neurobionics/a1201_springHead-master-1--20181022T163141Z-001/a1201_springHead-master (1)/Rouse_Changes/AssemDephy1.SLDASM

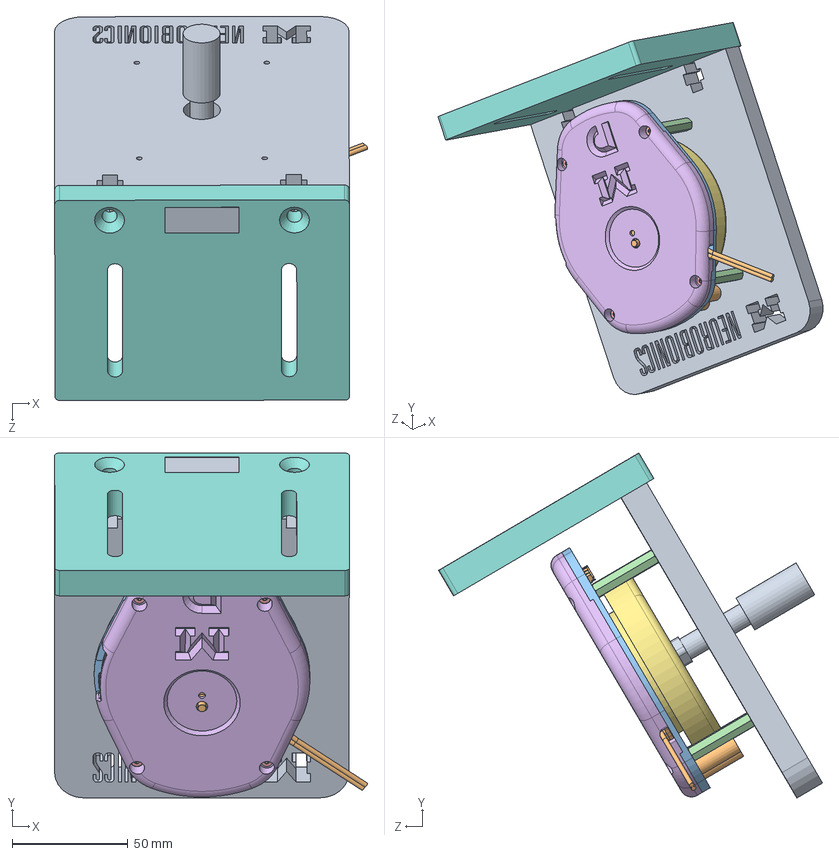
[picture p1: CAD file, 2019-01-08]
a1201_springHead-master (1)/Rouse_Changes/AssemDephy1.SLDASM
134.9 x 148.6 x 165.5 mm
front_MotorMount
DEPHY_FX_RIGID_0_1-simpler
mp-v1
95947A060_ALUM FEM THRDED HEX STANDOFF x 4
92855A309_TYPE 18-8 SS LOW PROFILE SOCKET CAP SCREW x 4
elec-cover-cap
D8-LM-2017-09-12
base_MotorMount
MotorShaft
