neurobionics/a1201_springHead-master-1--20181022T163141Z-001/a1201_springHead-master (1)/Rouse_Changes/a1201_springHead_newpart.SLDASM

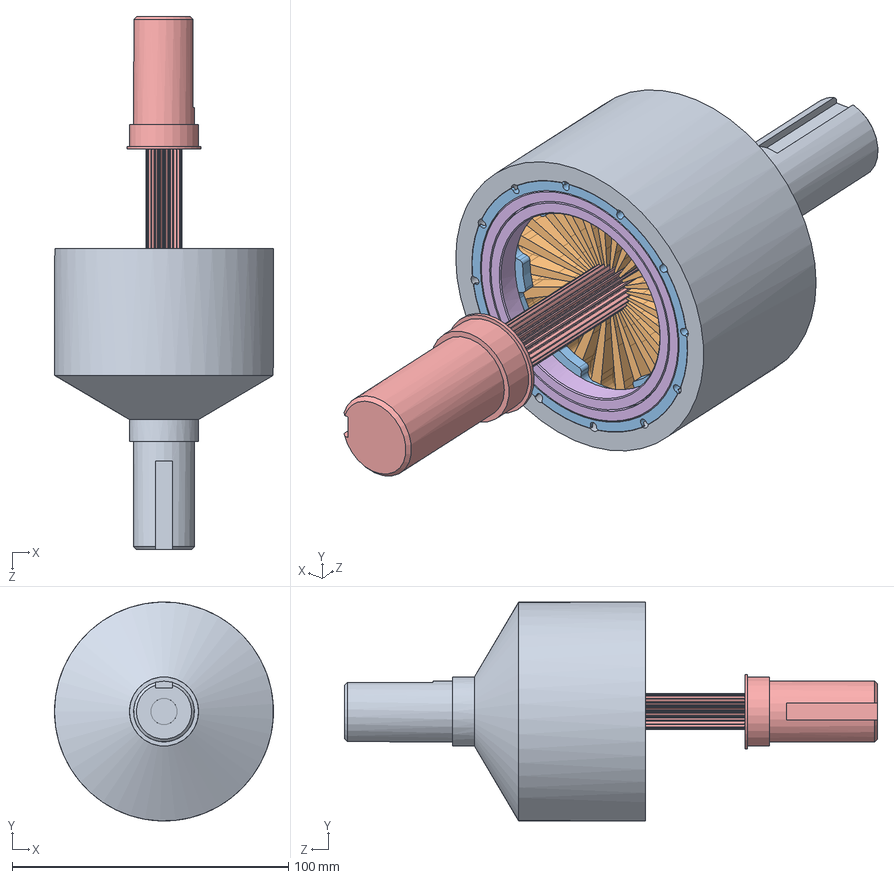
[picture p2: CAD file, 2019-01-08]
a1201_springHead-master (1)/Rouse_Changes/a1201_springHead_newpart.SLDASM
79.3 x 79.2 x 192.9 mm
p1012_stage3OutputPulley_5mm_48teeth_newpart
p1201_springV2 x 6
p1203_springStop
p1204_gearStopSpring
p1205_springGear_sdpsi_A_1C29MY05024_newpart
z_ultraThinBallBearing_mcmaster_6656K110
91595A142_METRIC ALLOY STEEL DOWEL PIN x 12
