neurobionics/a1201_springHead-master-1--20181022T163141Z-001/a1201_springHead-master (1)/PL2090-Double-P0403200503.SLDASM

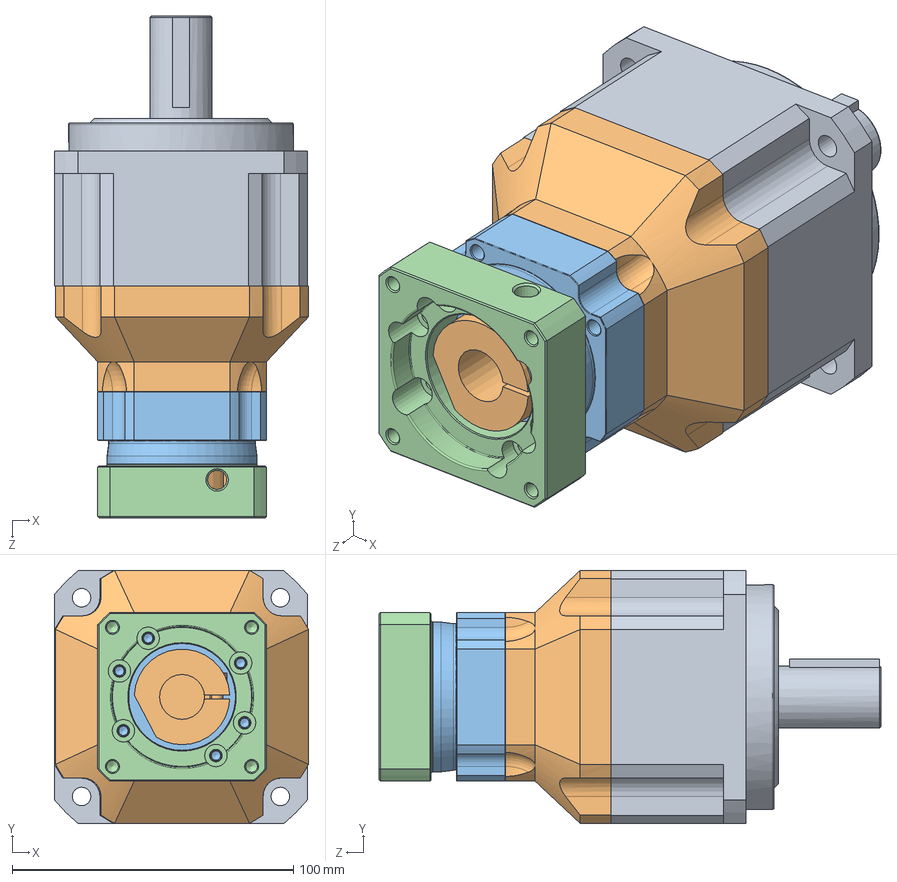
[picture p3: CAD file, 2018-11-18]
a1201_springHead-master (1)/PL2090-Double-P0403200503.SLDASM
90.4 x 90.1 x 178.5 mm
AB0902
AB0902-1
PK920001
P4120403
