neurobionics/a1201_springHead-master-1--20181022T163141Z-001/a1201_springHead-master (1)/Test Fixture parts/test fixture.SLDASM

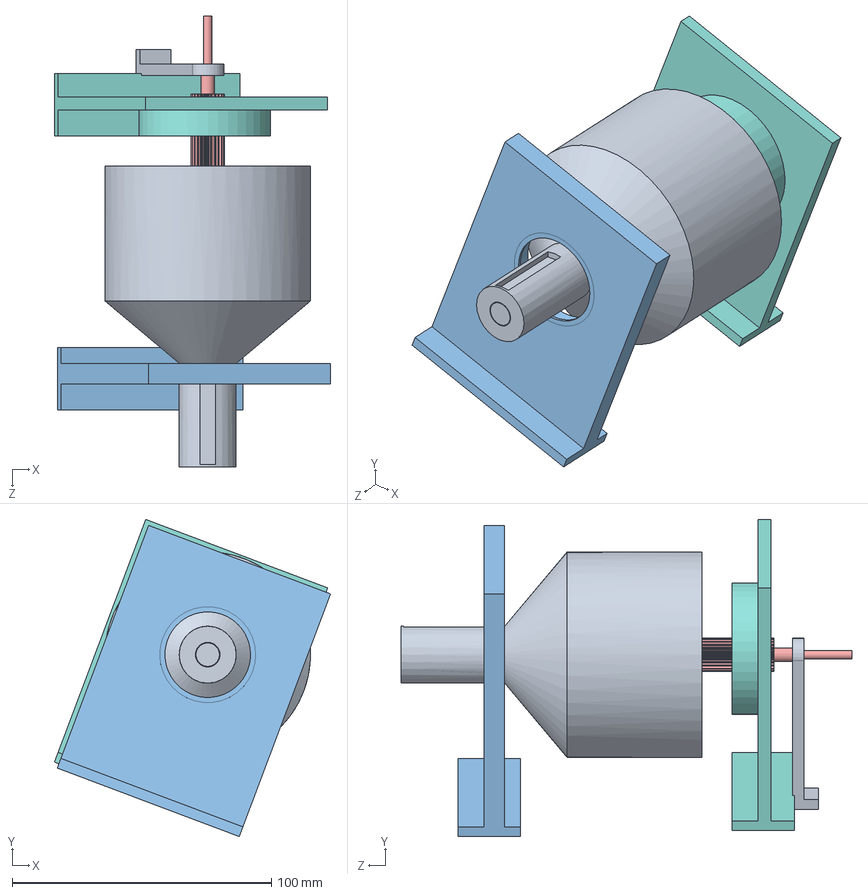
[picture p4: CAD file, 2018-10-22]
a1201_springHead-master (1)/Test Fixture parts/test fixture.SLDASM
106.5 x 122.3 x 173.9 mm
p1012_stage3OutputPulley_5mm_48teeth_newpart
p1201_springV2 x 6
p1203_springStop x 2
p1204_gearStopSpring x 2
p1205_springGear_sdpsi_A_1C29MY05024_newpart
z_ultraThinBallBearing_mcmaster_6656K110 x 2
z_dowelPin_3mm_5mm_mcmaster_91595A143 x 12
HoldingFixture
bearing fixture
57155K349_STAINLESS STEEL BALL BEARING x 2
HoldingFixtureRight
