neurobionics/a1201_springHead-master-1--20181022T163141Z-001/a1201_springHead-master (1)/Rouse_Changes/Motor-package.SLDASM

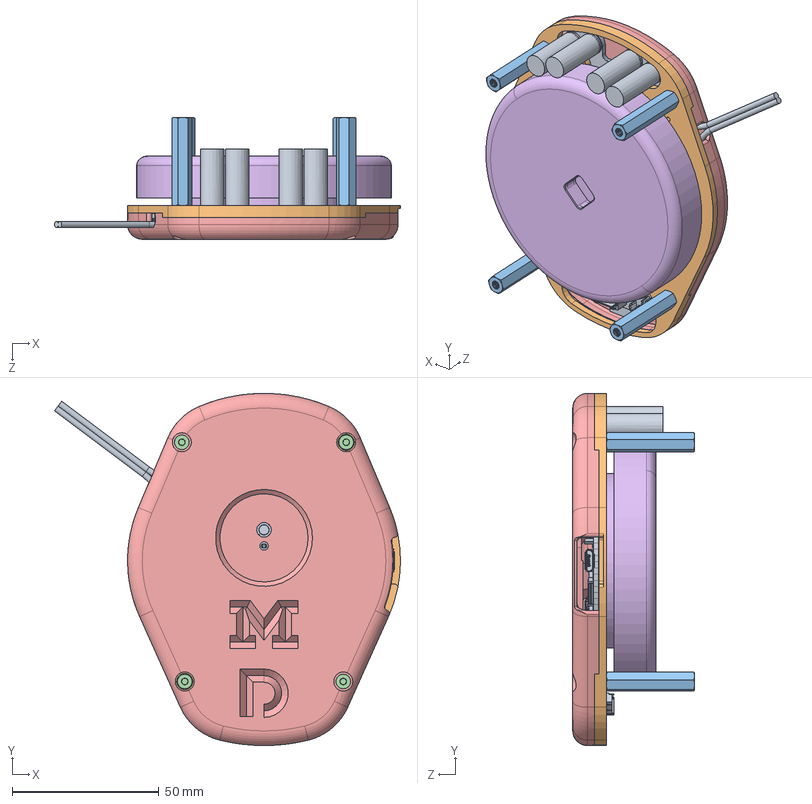
[picture p5: CAD file, 2018-12-12]
a1201_springHead-master (1)/Rouse_Changes/Motor-package.SLDASM
117.9 x 120.0 x 41.6 mm
DEPHY_FX_RIGID_0_1-simpler
mp-v1
95947A060_ALUM FEM THRDED HEX STANDOFF x 4
92855A309_TYPE 18-8 SS LOW PROFILE SOCKET CAP SCREW x 4
elec-cover-cap
D8-LM-2017-09-12
