neurobionics/a1201_springHead-master-1--20181022T163141Z-001/a1201_springHead-master (1)/a1201_springHead.SLDASM

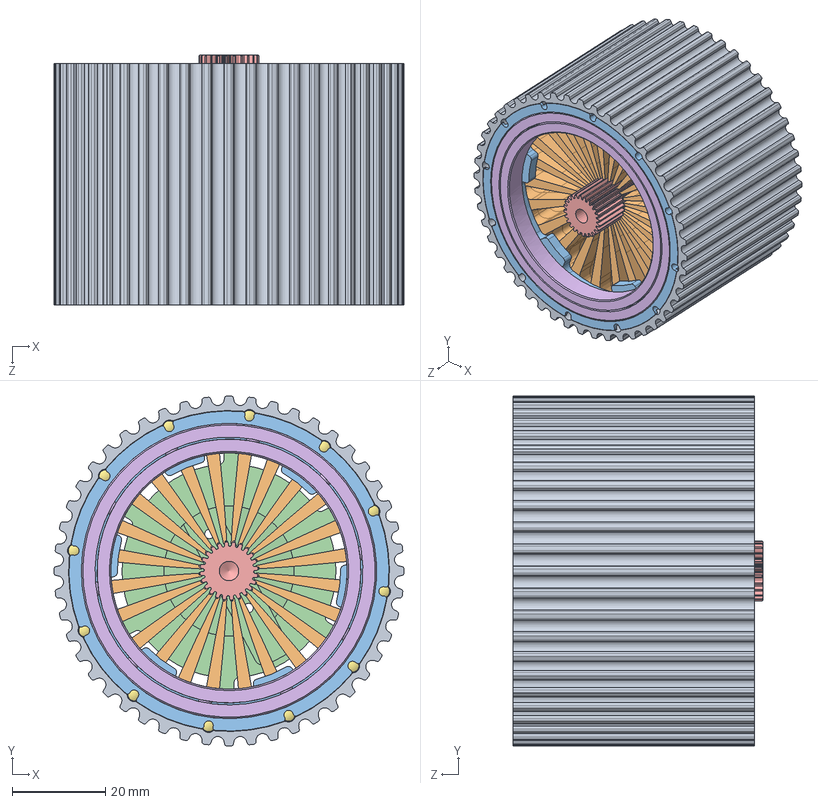
[picture p7: CAD file, 2018-10-22]
a1201_springHead-master (1)/a1201_springHead.SLDASM
75.3 x 75.3 x 53.8 mm
p1012_stage3OutputPulley_5mm_48teeth_sdpsi_A_6A54M048GT20
p1201_springV2 x 6
p1203_springStop x 2
p1204_gearStopSpring x 2
p1205_springGear_sdpsi_A_1C29MY05024
z_ultraThinBallBearing_mcmaster_6656K110 x 2
z_dowelPin_3mm_5mm_mcmaster_91595A143 x 12
