neurobionics/a1201_springHead-master-1--20181022T163141Z-001/a1201_springHead-master (1)/p1012_stage3OutputPulley_5mm_48teeth_newpart.STEP

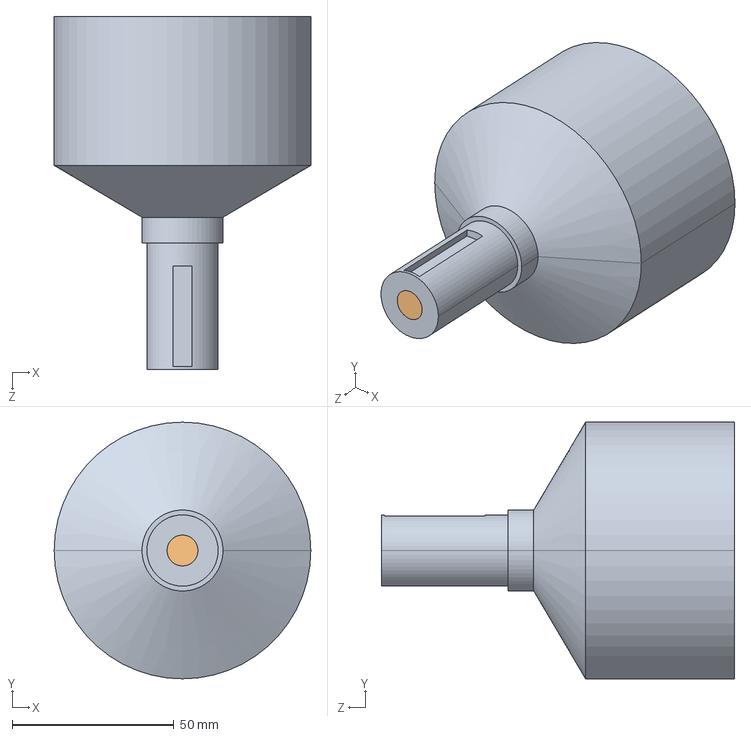
[picture p9: CAD file, 2019-01-06]
a1201_springHead-master (1)/p1012_stage3OutputPulley_5mm_48teeth_newpart.STEP
79.3 x 79.3 x 109.0 mm
