neurobionics/a1201_springHead-master-1--20181022T163141Z-001/a1201_springHead-master (1)/parts for quotes/holding fixture base 2.STEP

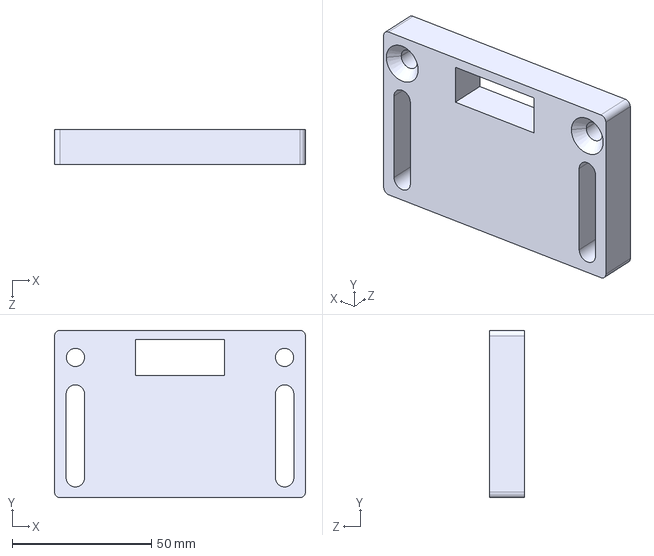
[picture p10: CAD file, 2019-01-06]
a1201_springHead-master (1)/parts for quotes/holding fixture base 2.STEP
90.0 x 60.0 x 12.7 mm
