neurobionics/a1201_springHead-master-1--20181022T163141Z-001/a1201_springHead-master (1)/Rouse_Changes/MB6090_M-Solidworks.SLDPRT

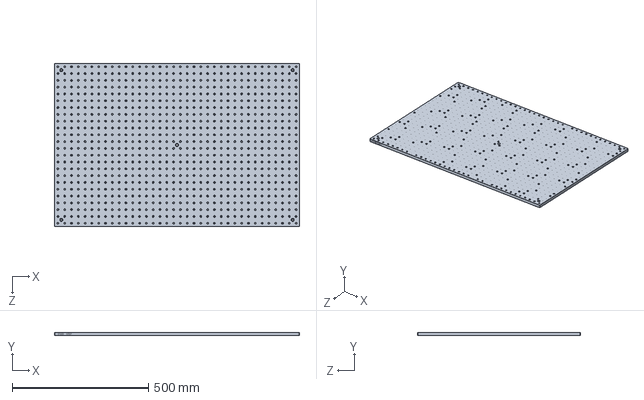
[picture p11: CAD file, 2019-01-11]
a1201_springHead-master (1)/Rouse_Changes/MB6090_M-Solidworks.SLDPRT
900.0 x 12.7 x 600.0 mm
