neurobionics/a1201_springHead-master-1--20181022T163141Z-001/a1201_springHead-master (1)/Key.STEP

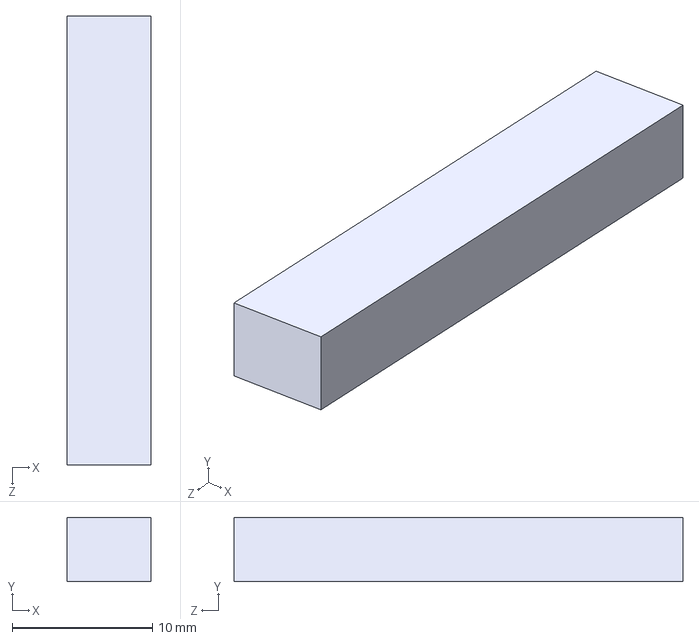
[picture p12: CAD file, 2019-01-06]
a1201_springHead-master (1)/Key.STEP
6.00 x 4.58 x 32.0 mm
