neurobionics/a1201_springHead-master-1--20181022T163141Z-001/a1201_springHead-master (1)/parts for quotes/base_MotorMount.STEP

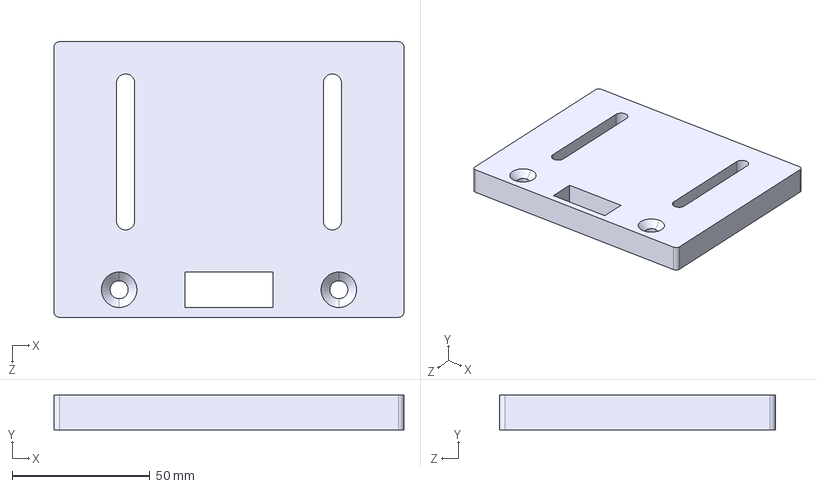
[picture p13: CAD file, 2019-01-06]
a1201_springHead-master (1)/parts for quotes/base_MotorMount.STEP
127.0 x 12.7 x 100.0 mm
