neurobionics/a1201_springHead-master-1--20181022T163141Z-001/a1201_springHead-master (1)/Test Fixture parts/HoldingFixtureRight.SLDPRT

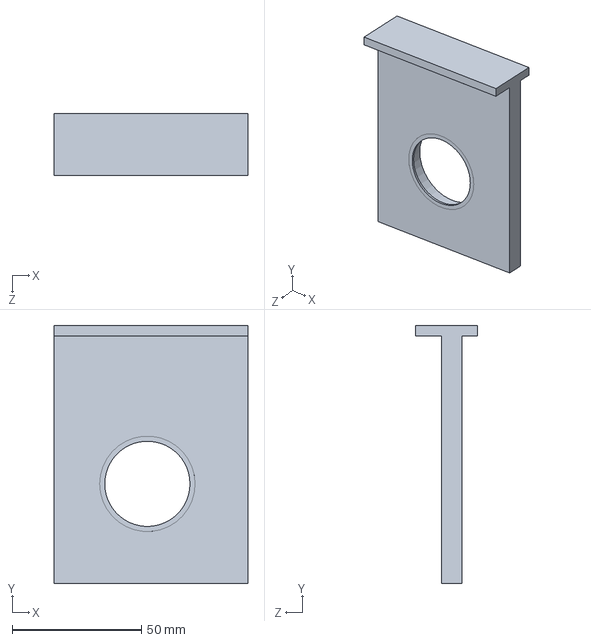
[picture p15: CAD file, 2018-10-22]
a1201_springHead-master (1)/Test Fixture parts/HoldingFixtureRight.SLDPRT
75.0 x 100.0 x 24.0 mm
