neurobionics/a1201_springHead-master-1--20181022T163141Z-001/a1201_springHead-master (1)/p1205_springGear_sdpsi_A_1C29MY05024_newpart.STEP

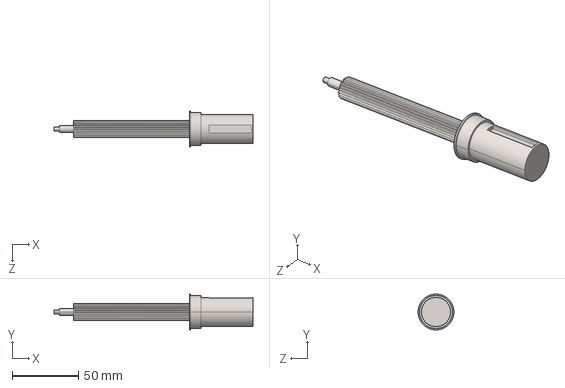
[picture p16: CAD file, 2019-01-06]
a1201_springHead-master (1)/p1205_springGear_sdpsi_A_1C29MY05024_newpart.STEP
149.9 x 27.0 x 27.0 mm
