neurobionics/a1201_springHead-master-1--20181022T163141Z-001/a1201_springHead-master (1)/parts for quotes/transmission coupler.STEP

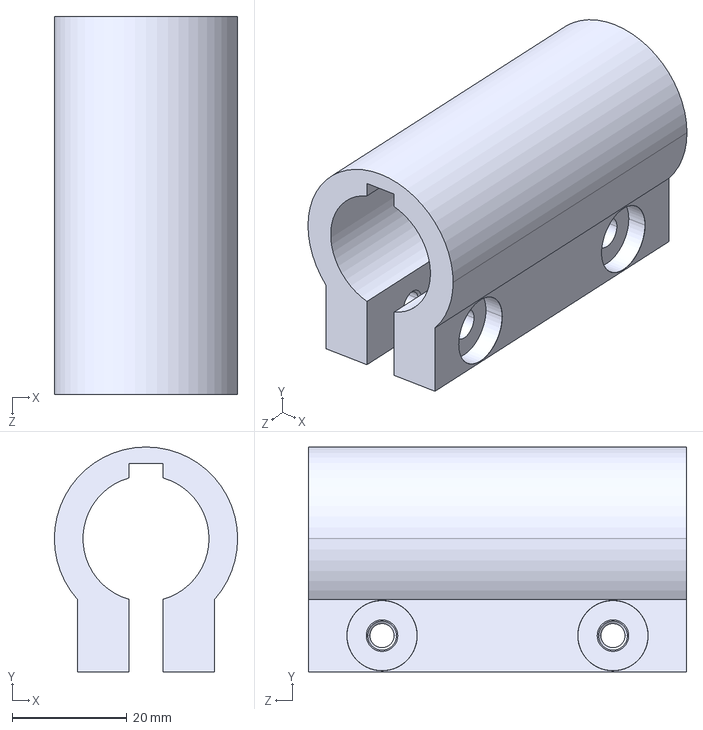
[picture p17: CAD file, 2019-01-06]
a1201_springHead-master (1)/parts for quotes/transmission coupler.STEP
32.0 x 39.3 x 66.0 mm
