neurobionics/a1201_springHead-master-1--20181022T163141Z-001/a1201_springHead-master (1)/Test Fixture parts/p1204_gearStopSpring.SLDPRT

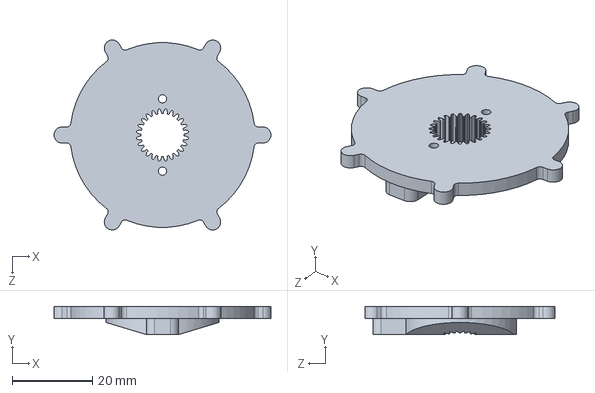
[picture p18: CAD file, 2018-10-22]
a1201_springHead-master (1)/Test Fixture parts/p1204_gearStopSpring.SLDPRT
54.0 x 7.00 x 47.3 mm
