neurobionics/a1201_springHead-master-1--20181022T163141Z-001/a1201_springHead-master (1)/HoldingFixtureRight.STEP

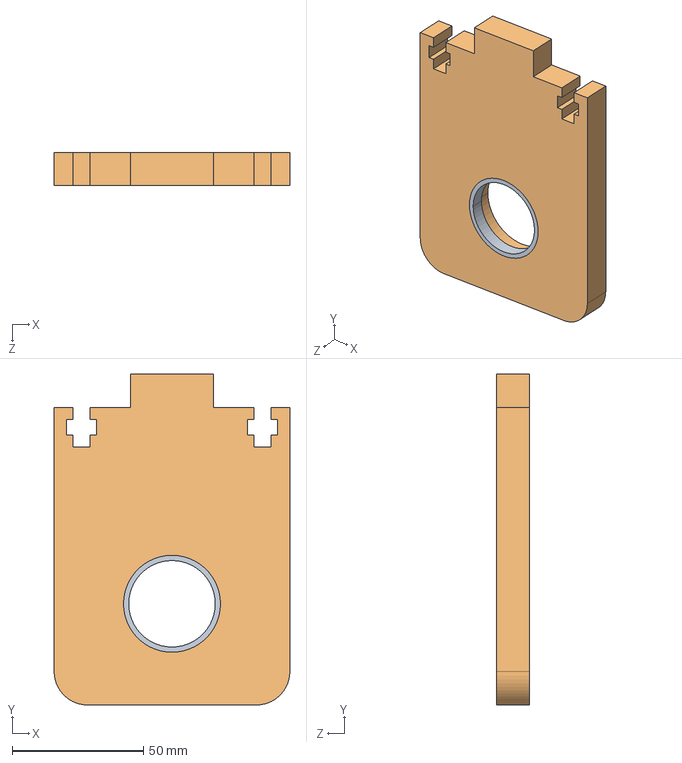
[picture p19: CAD file, 2019-01-06]
a1201_springHead-master (1)/HoldingFixtureRight.STEP
90.0 x 126.3 x 12.7 mm
