neurobionics/a1201_springHead-master-1--20181022T163141Z-001/a1201_springHead-master (1)/parts for quotes/HoldingFixture.STEP

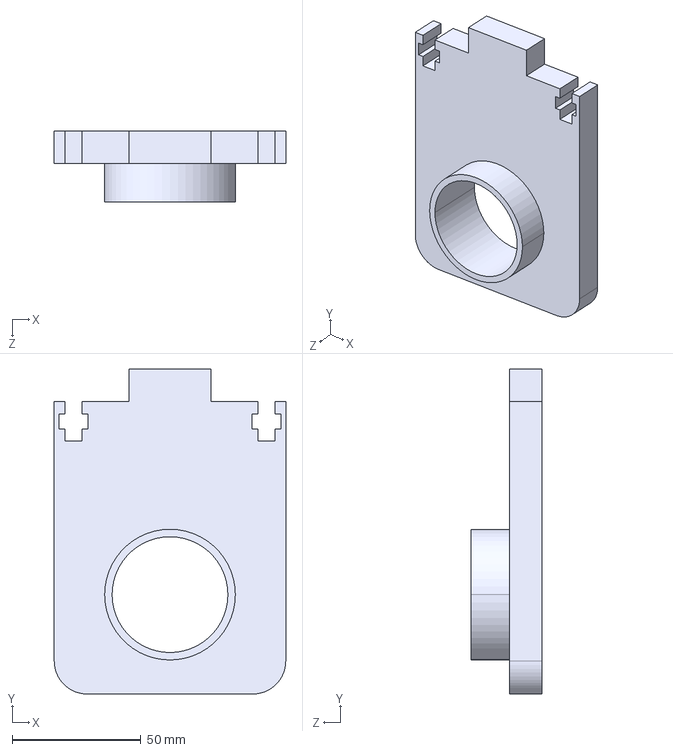
[picture p20: CAD file, 2019-01-06]
a1201_springHead-master (1)/parts for quotes/HoldingFixture.STEP
90.0 x 126.3 x 27.7 mm
