neurobionics/a1201_springHead-master-1--20181022T163141Z-001/a1201_springHead-master (1)/Test Fixture parts/p1205_springGear_sdpsi_A_1C29MY05024_newpart.SLDPRT

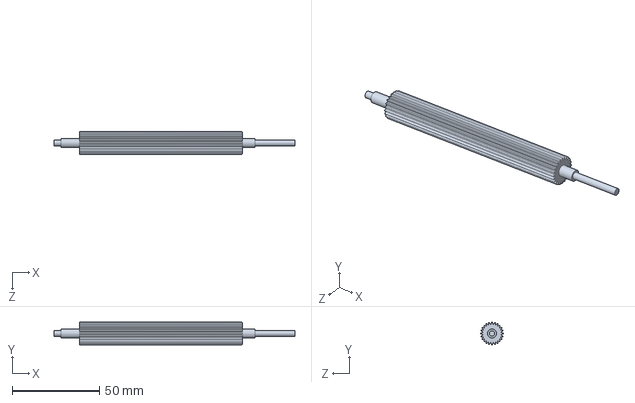
[picture p21: CAD file, 2018-10-22]
a1201_springHead-master (1)/Test Fixture parts/p1205_springGear_sdpsi_A_1C29MY05024_newpart.SLDPRT
137.9 x 13.0 x 13.0 mm
