neurobionics/a1201_springHead-master-1--20181022T163141Z-001/a1201_springHead-master (1)/parts for quotes/holding fixture base1.STEP

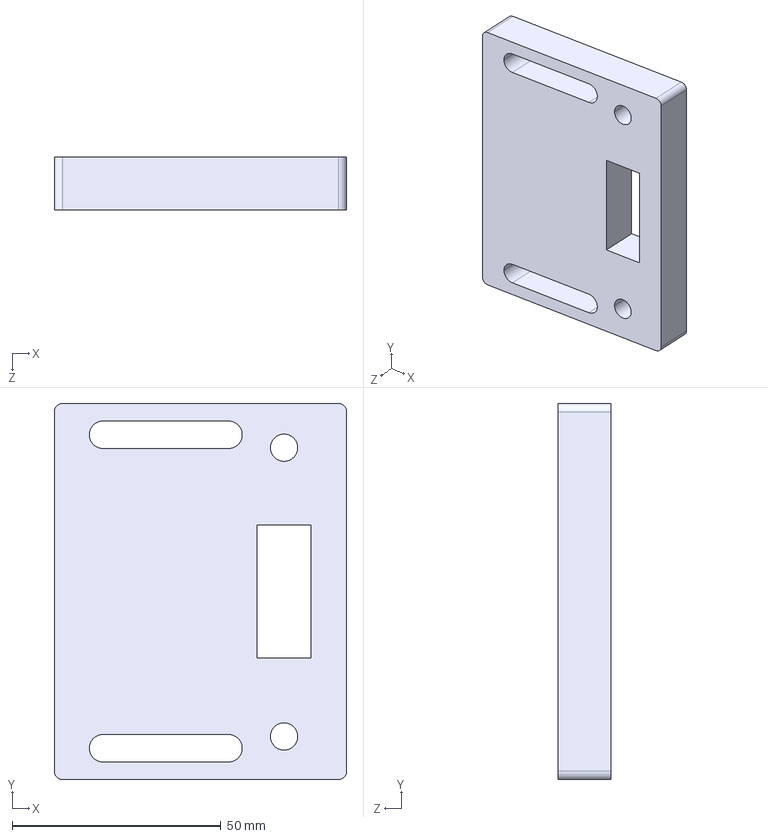
[picture p22: CAD file, 2019-01-06]
a1201_springHead-master (1)/parts for quotes/holding fixture base1.STEP
70.0 x 90.0 x 12.7 mm
