neurobionics/a1201_springHead-master-1--20181022T163141Z-001/a1201_springHead-master (1)/Rouse_Changes/p1203_springStop.STEP

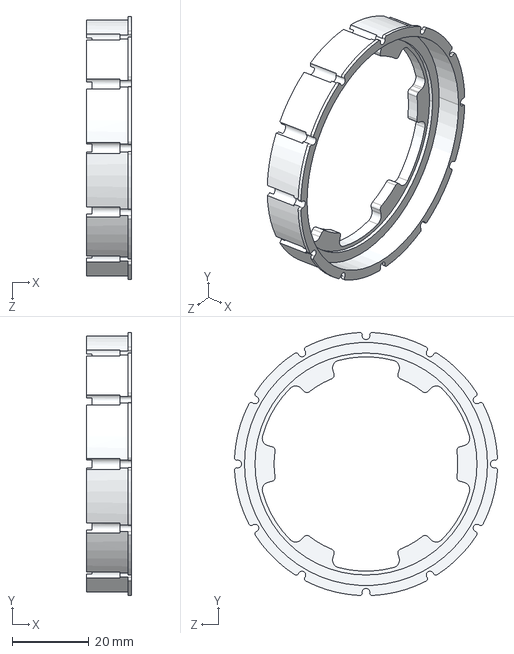
[picture p23: CAD file, 2019-01-08]
a1201_springHead-master (1)/Rouse_Changes/p1203_springStop.STEP
11.7 x 68.7 x 68.7 mm
