neurobionics/a1201_springHead-master-1--20181022T163141Z-001/a1201_springHead-master (1)/Test Fixture parts/p1201_springV2.SLDPRT

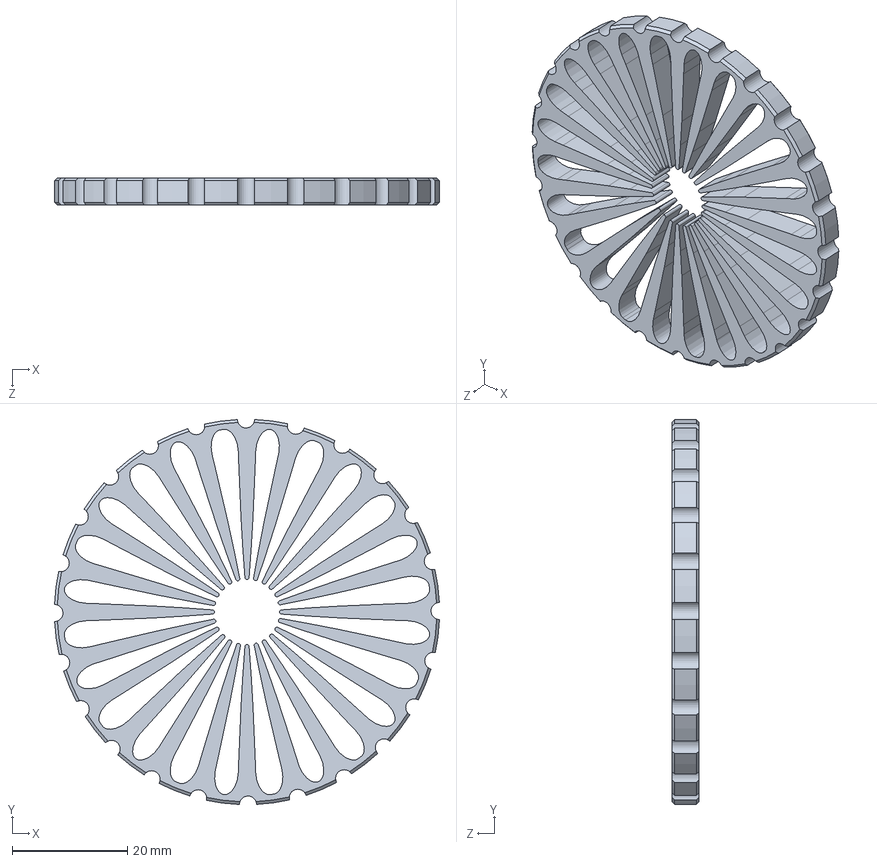
[picture p24: CAD file, 2018-10-22]
a1201_springHead-master (1)/Test Fixture parts/p1201_springV2.SLDPRT
66.9 x 66.9 x 4.76 mm
