neurobionics/a1201_springHead-master-1--20181022T163141Z-001/a1201_springHead-master (1)/AB0902.sldprt

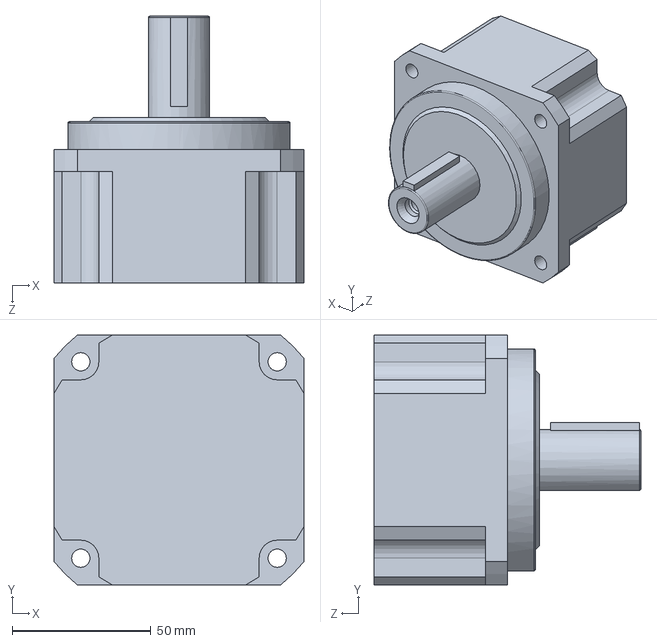
[picture p25: CAD file, 2018-11-18]
a1201_springHead-master (1)/AB0902.sldprt
90.0 x 90.0 x 96.0 mm
