neurobionics/a1201_springHead-master-1--20181022T163141Z-001/a1201_springHead-master (1)/parts for quotes/transmission mount 2.STEP

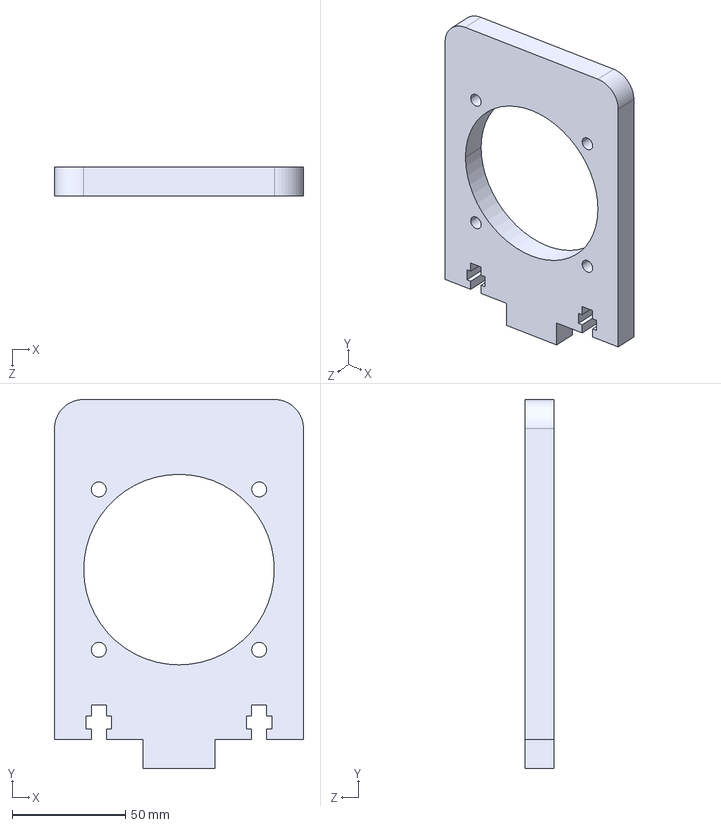
[picture p26: CAD file, 2019-01-06]
a1201_springHead-master (1)/parts for quotes/transmission mount 2.STEP
109.8 x 162.7 x 12.7 mm
