neurobionics/a1201_springHead-master-1--20181022T163141Z-001/a1201_springHead-master (1)/Rouse_Changes/front_MotorMount.STEP

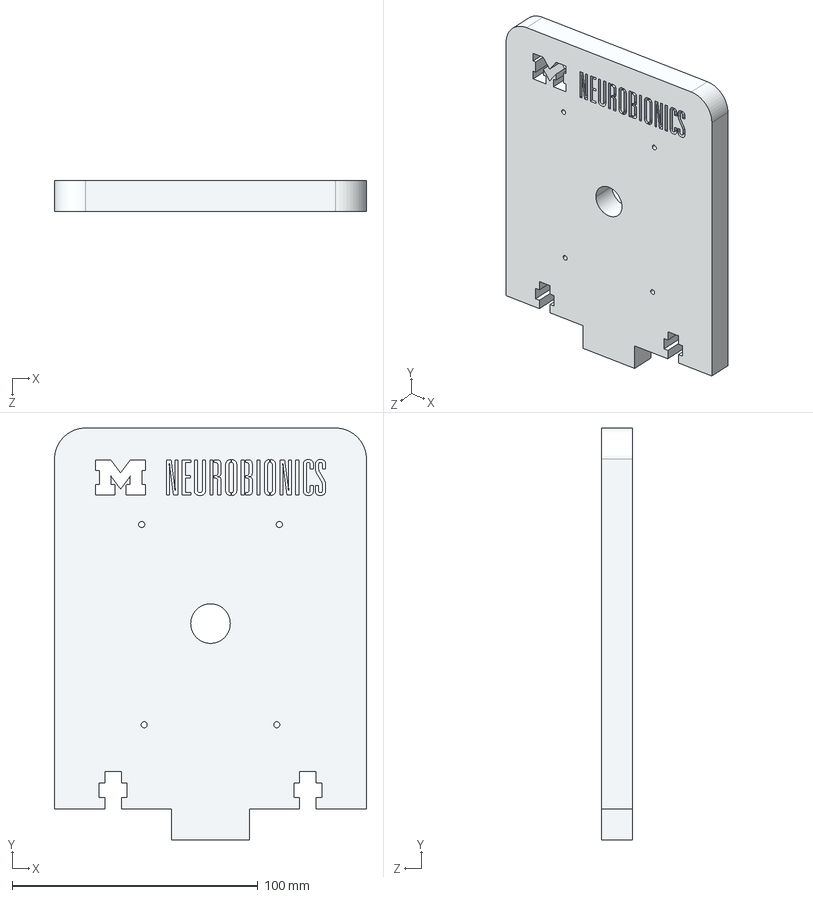
[picture p27: CAD file, 2019-01-06]
a1201_springHead-master (1)/Rouse_Changes/front_MotorMount.STEP
127.0 x 167.7 x 12.7 mm
