neurobionics/a1201_springHead-master-1--20181022T163141Z-001/a1201_springHead-master (1)/Rouse_Changes/transmission mount base.STEP

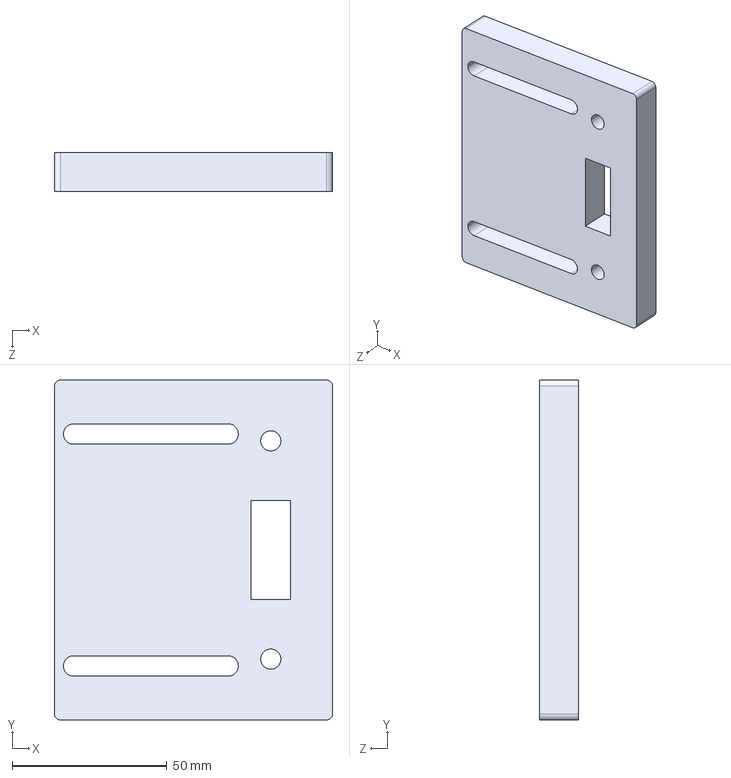
[picture p29: CAD file, 2019-01-06]
a1201_springHead-master (1)/Rouse_Changes/transmission mount base.STEP
90.0 x 110.0 x 12.7 mm
