neurobionics/a1201_springHead-master-1--20181022T163141Z-001/a1201_springHead-master (1)/Test Fixture parts/bearing fixture.SLDPRT

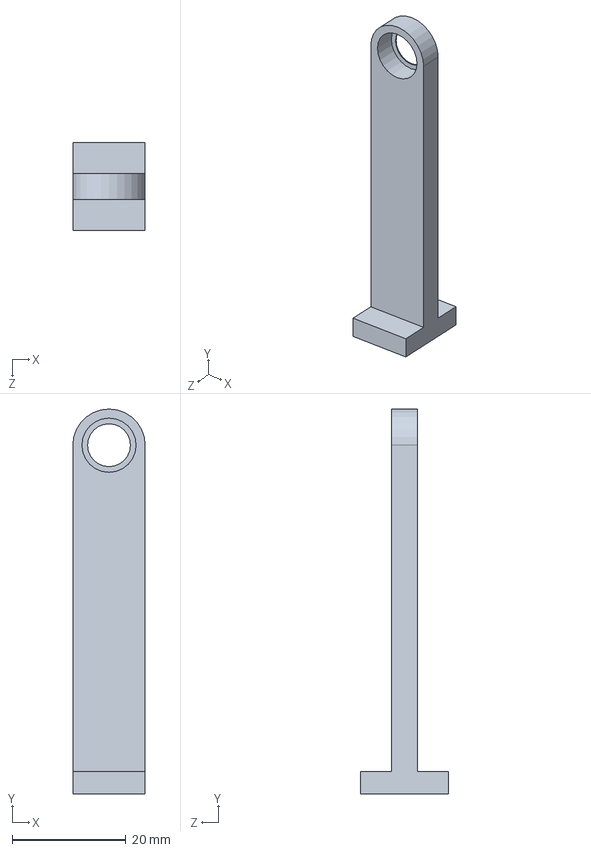
[picture p30: CAD file, 2018-10-22]
a1201_springHead-master (1)/Test Fixture parts/bearing fixture.SLDPRT
12.7 x 67.7 x 15.5 mm
