neurobionics/a1201_springHead-master-1--20181022T163141Z-001/a1201_springHead-master (1)/transmission mount 2.SLDPRT

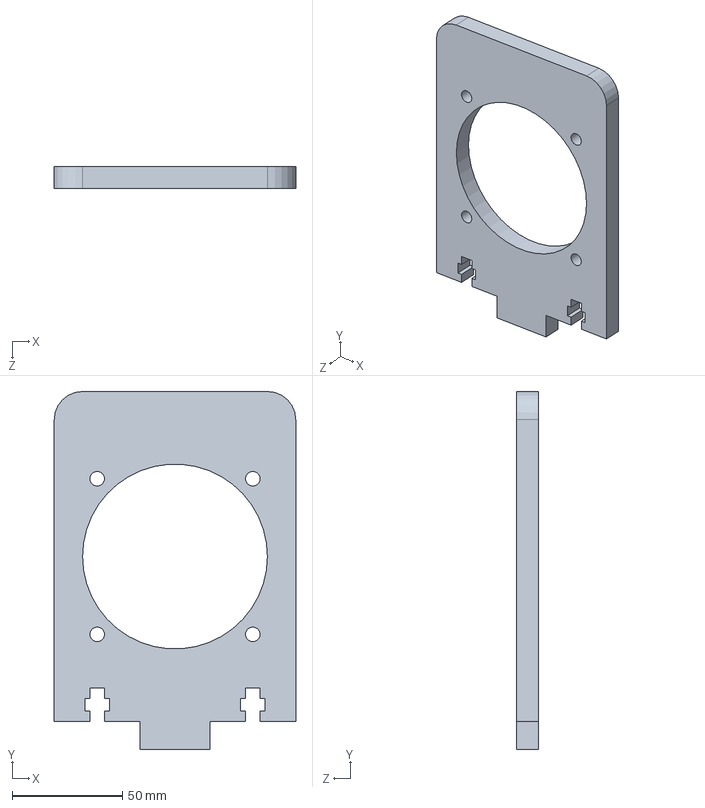
[picture p31: CAD file, 2018-11-18]
a1201_springHead-master (1)/transmission mount 2.SLDPRT
109.8 x 162.7 x 10.0 mm
