neurobionics/a1201_springHead-master-1--20181022T163141Z-001/a1201_springHead-master (1)/Rouse_Changes/HoldingFixtureRight.SLDPRT

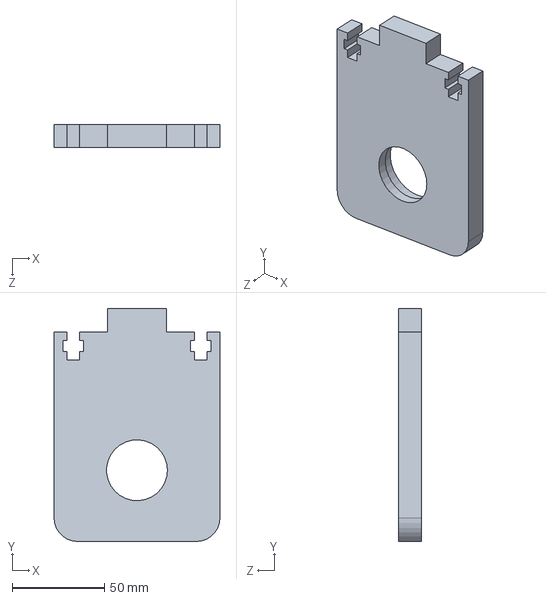
[picture p33: CAD file, 2018-12-21]
a1201_springHead-master (1)/Rouse_Changes/HoldingFixtureRight.SLDPRT
90.0 x 126.3 x 12.7 mm
