neurobionics/a1201_springHead-master-1--20181022T163141Z-001/a1201_springHead-master (1)/Rouse_Changes/transmission coupler.SLDPRT

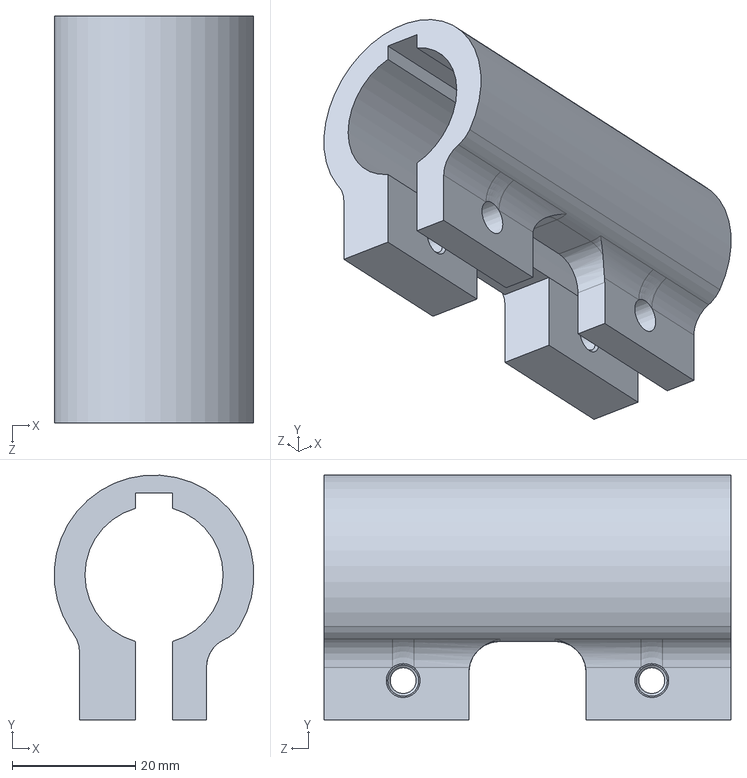
[picture p34: CAD file, 2018-12-21]
a1201_springHead-master (1)/Rouse_Changes/transmission coupler.SLDPRT
32.3 x 39.7 x 66.0 mm
