neurobionics/a1201_springHead-master-1--20181022T163141Z-001/a1201_springHead-master (1)/holdingfixture base.SLDPRT

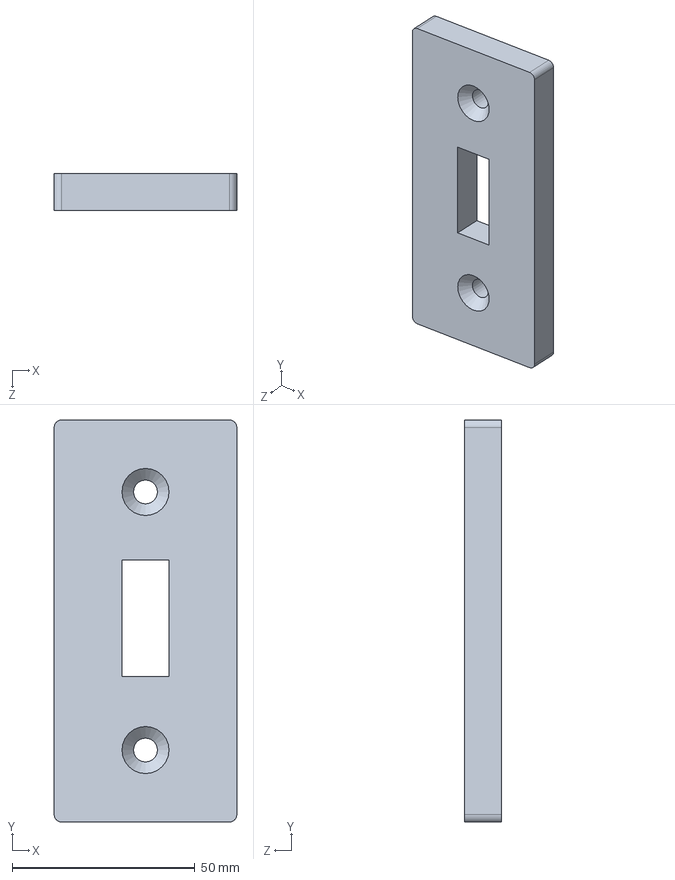
[picture p35: CAD file, 2018-10-26]
a1201_springHead-master (1)/holdingfixture base.SLDPRT
50.0 x 110.0 x 10.0 mm
