neurobionics/a1201_springHead-master-1--20181022T163141Z-001/a1201_springHead-master (1)/transmission mount.SLDPRT

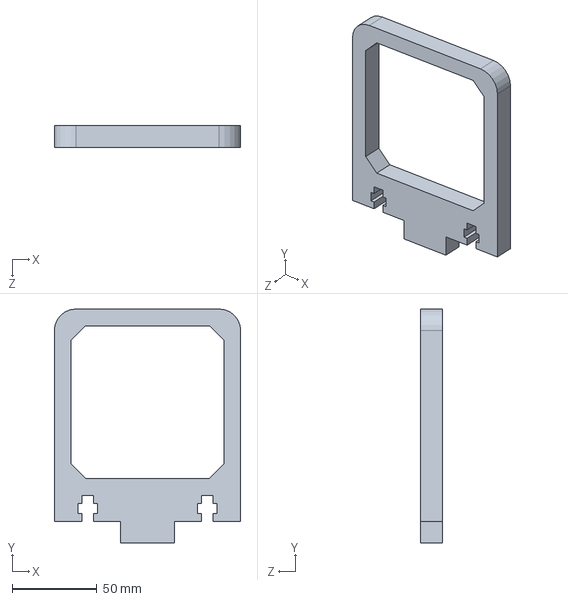
[picture p36: CAD file, 2018-10-25]
a1201_springHead-master (1)/transmission mount.SLDPRT
110.0 x 138.1 x 12.7 mm
