neurobionics/a1201_springHead-master-1--20181022T163141Z-001/a1201_springHead-master (1)/Rouse_Changes/elec-cover-cap.SLDPRT

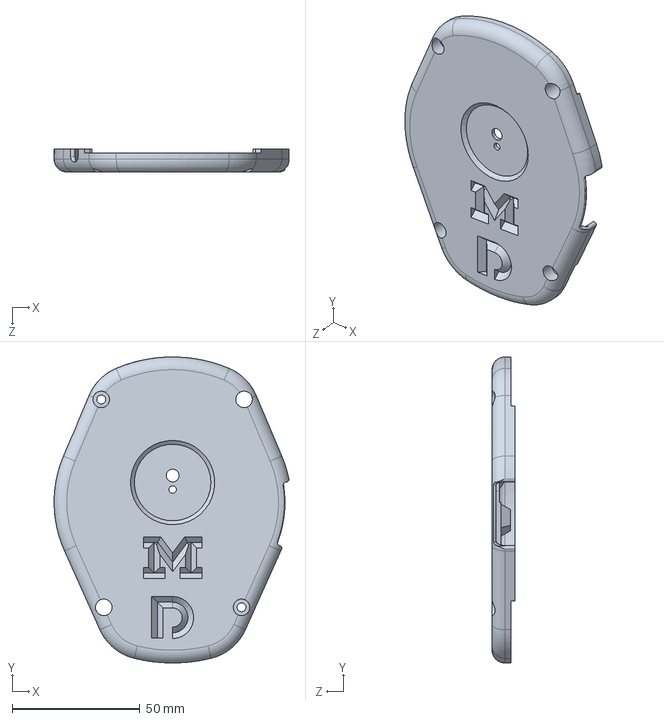
[picture p38: CAD file, 2018-12-12]
a1201_springHead-master (1)/Rouse_Changes/elec-cover-cap.SLDPRT
92.1 x 120.0 x 9.00 mm
