neurobionics/a1201_springHead-master-1--20181022T163141Z-001/a1201_springHead-master (1)/p1012_stage3OutputPulley_5mm_48teeth_sdpsi_A_6A54M048GT20.SLDPRT

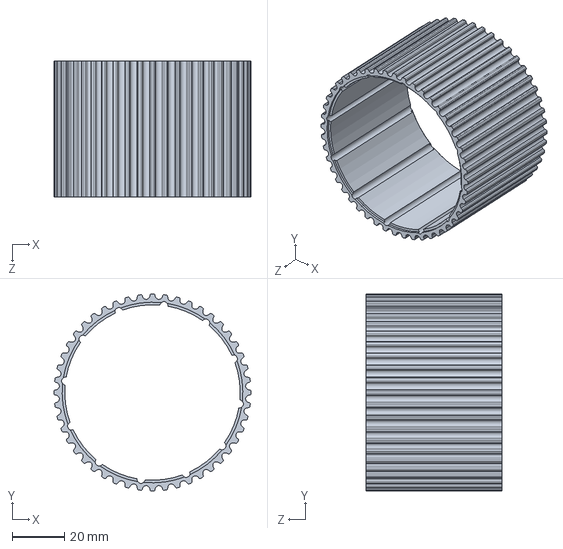
[picture p39: CAD file, 2018-10-22]
a1201_springHead-master (1)/p1012_stage3OutputPulley_5mm_48teeth_sdpsi_A_6A54M048GT20.SLDPRT
75.3 x 75.3 x 52.0 mm
