neurobionics/a1201_springHead-master-1--20181022T163141Z-001/a1201_springHead-master (1)/Rouse_Changes/mp-v1.SLDPRT

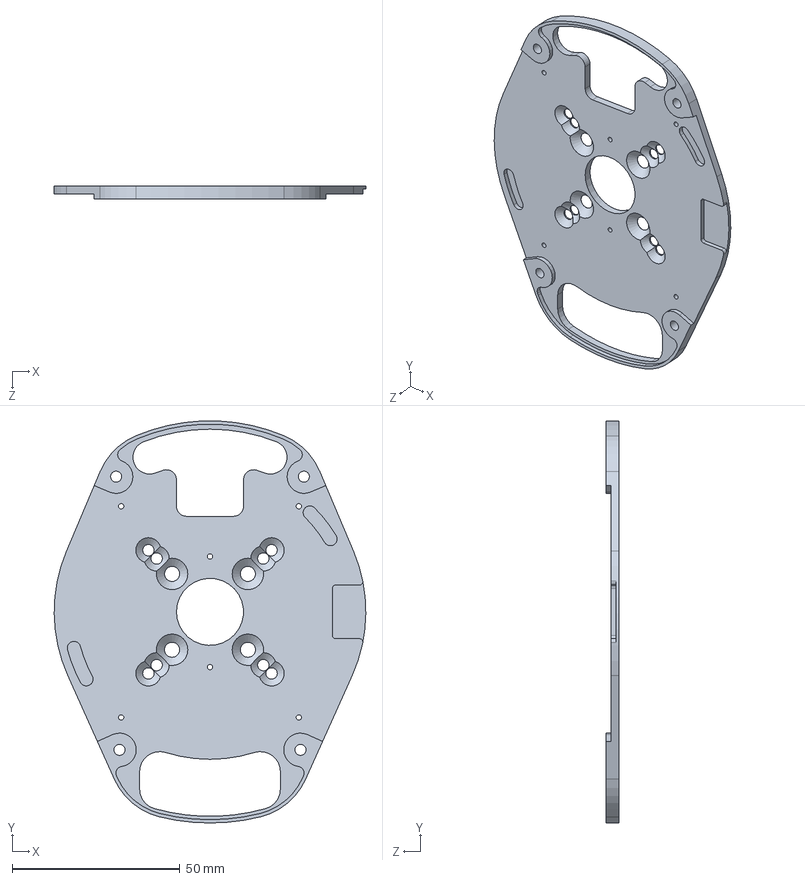
[picture p40: CAD file, 2018-12-12]
a1201_springHead-master (1)/Rouse_Changes/mp-v1.SLDPRT
93.0 x 119.9 x 4.00 mm
