neurobionics/a1201_springHead-master-1--20181022T163141Z-001/a1201_springHead-master (1)/inner gear shaft.SLDPRT

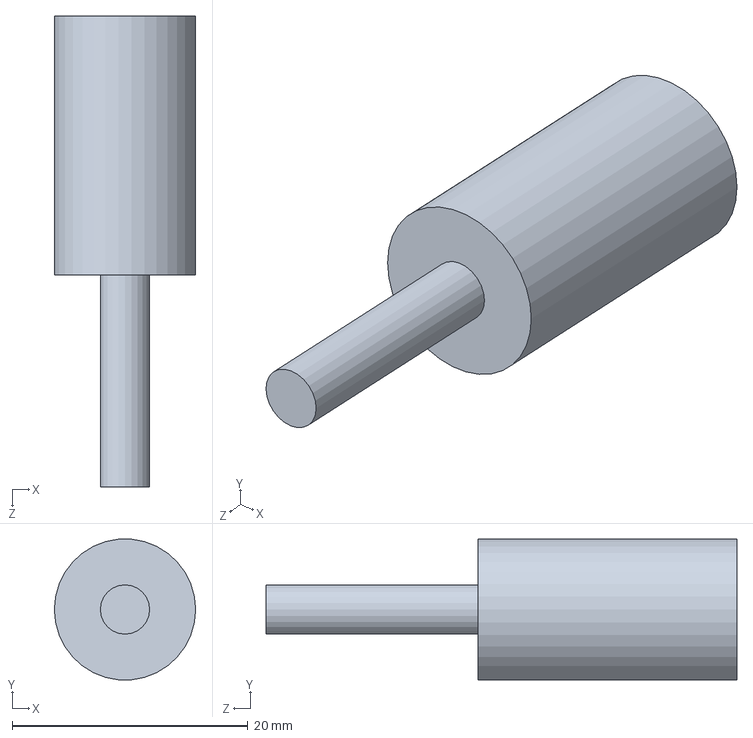
[picture p41: CAD file, 2018-10-22]
a1201_springHead-master (1)/inner gear shaft.SLDPRT
12.0 x 11.9 x 40.0 mm
