neurobionics/a1201_springHead-master-1--20181022T163141Z-001/a1201_springHead-master (1)/Rouse_Changes/D8-LM-2017-09-12.SLDPRT

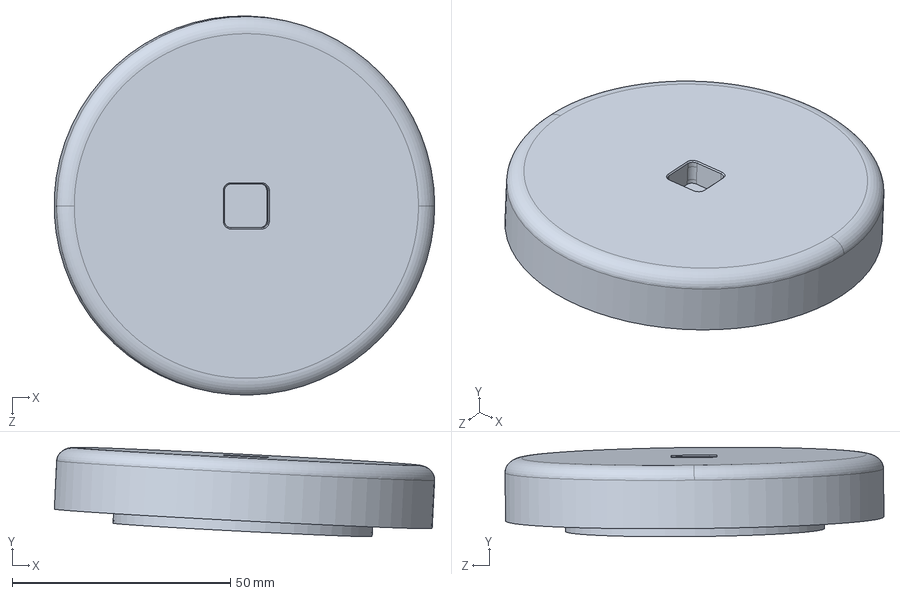
[picture p42: CAD file, 2018-12-12]
a1201_springHead-master (1)/Rouse_Changes/D8-LM-2017-09-12.SLDPRT
87.2 x 20.5 x 86.9 mm
