neurobionics/a1201_springHead-master-1--20181022T163141Z-001/a1201_springHead-master (1)/PGD110-50A2.STEP

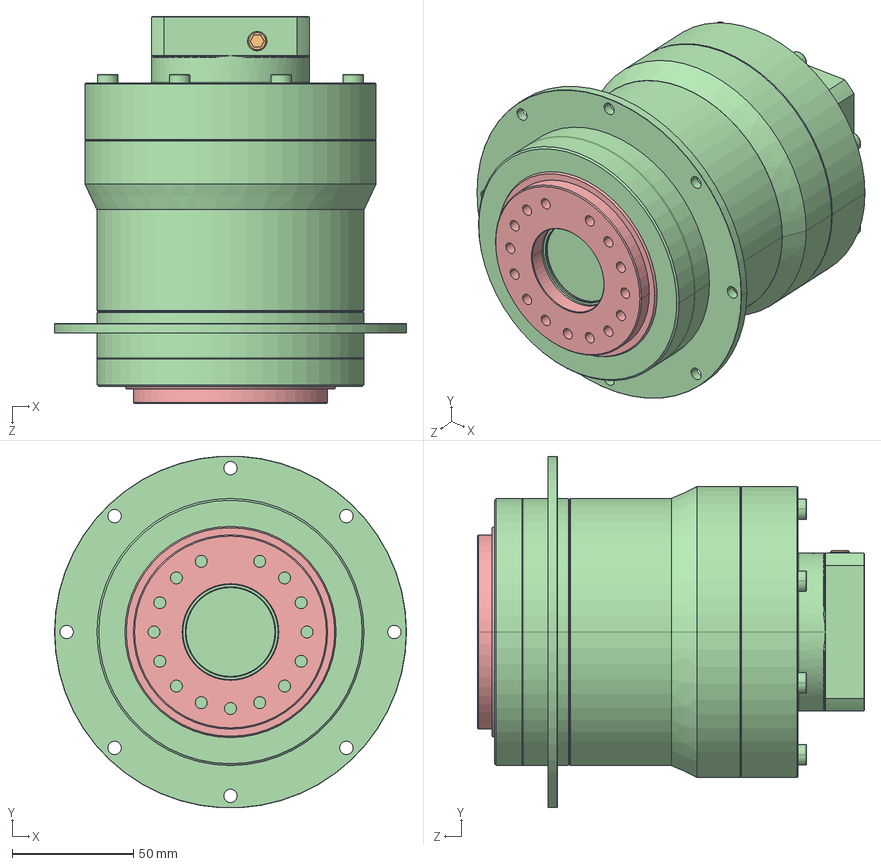
[picture p43: CAD file, 2018-10-22]
a1201_springHead-master (1)/PGD110-50A2.STEP
145.0 x 144.8 x 159.5 mm
