neurobionics/a1201_springHead-master-1--20181022T163141Z-001/a1201_springHead-master (1)/motor coupling.SLDPRT

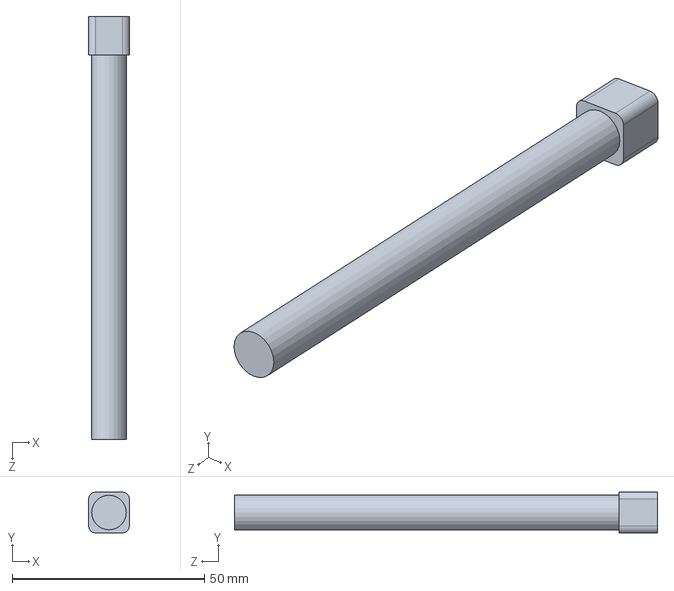
[picture p44: CAD file, 2018-10-22]
a1201_springHead-master (1)/motor coupling.SLDPRT
10.6 x 10.6 x 110.0 mm
