neurobionics/a1201_springHead-master-1--20181022T163141Z-001/(list of files, cad)

Other CAD files:
a1201_springHead-master (1)/a1201_springHead_newpart.SLDASM
a1201_springHead-master (1)/AssemDephy1.SLDASM
a1201_springHead-master (1)/Rouse_Changes/PL2090-Double-P0403200503.SLDASM
a1201_springHead-master (1)/Rouse_Changes/p1204_gearStopSpring.STEP
a1201_springHead-master (1)/Test Fixture parts/p1203_springStop.SLDPRT
a1201_springHead-master (1)/holding fixture base1.SLDPRT
a1201_springHead-master (1)/base_MotorMount.SLDPRT
a1201_springHead-master (1)/front_MotorMount.SLDPRT
a1201_springHead-master (1)/holding fixture base 3.SLDPRT
a1201_springHead-master (1)/Rouse_Changes/HoldingFixture.SLDPRT
a1201_springHead-master (1)/holding fixture base 2.SLDPRT
a1201_springHead-master (1)/Rouse_Changes/p1012_stage3OutputPulley_5mm_48teeth_newpart.SLDPRT
a1201_springHead-master (1)/transmission mount base.SLDPRT
a1201_springHead-master (1)/Rouse_Changes/p1201_springV2.SLDPRT
a1201_springHead-master (1)/MotorShaft.SLDPRT
a1201_springHead-master (1)/Rouse_Changes/Key.SLDPRT
a1201_springHead-master (1)/AB0902-1.sldprt
a1201_springHead-master (1)/Rouse_Changes/AB0902.sldprt
a1201_springHead-master (1)/Rouse_Changes/AB0902-1.sldprt
a1201_springHead-master (1)/p1201_springV2.SLDPRT
a1201_springHead-master (1)/Rouse_Changes/p1205_springGear_sdpsi_A_1C29MY05024_newpart.SLDPRT
a1201_springHead-master (1)/p1204_gearStopSpring.SLDPRT
a1201_springHead-master (1)/p1203_springStop.SLDPRT
a1201_springHead-master (1)/bearing fixture.SLDPRT
a1201_springHead-master (1)/57155K349_STAINLESS STEEL BALL BEARING.SLDPRT
a1201_springHead-master (1)/5972K216_BALL BEARING_BIG.SLDPRT
a1201_springHead-master (1)/5972K216_BALL BEARING_BIG.x_t
a1201_springHead-master (1)/64815K450_PRECISION SPEED REDUCER.SLDPRT
a1201_springHead-master (1)/91595A142_METRIC ALLOY STEEL DOWEL PIN.SLDPRT
a1201_springHead-master (1)/HoldingFixture.SLDPRT
a1201_springHead-master (1)/HoldingFixtureRight.SLDPRT
a1201_springHead-master (1)/Key.SLDPRT
a1201_springHead-master (1)/P4120403.sldprt
a1201_springHead-master (1)/PGD110-50A2.SLDPRT
a1201_springHead-master (1)/PK920001.sldprt
a1201_springHead-master (1)/Rouse_Changes/57155K349_STAINLESS STEEL BALL BEARING.SLDPRT
a1201_springHead-master (1)/Rouse_Changes/5972K216_BALL BEARING_BIG.SLDPRT
a1201_springHead-master (1)/Rouse_Changes/91595A142_METRIC ALLOY STEEL DOWEL PIN.SLDPRT
a1201_springHead-master (1)/Rouse_Changes/92855A309_TYPE 18-8 SS LOW PROFILE SOCKET CAP SCREW.SLDPRT
a1201_springHead-master (1)/Rouse_Changes/95947A060_ALUM FEM THRDED HEX STANDOFF.SLDPRT
a1201_springHead-master (1)/Rouse_Changes/MotorShaft.SLDPRT
a1201_springHead-master (1)/Rouse_Changes/P4120403.sldprt
a1201_springHead-master (1)/Rouse_Changes/PK920001.sldprt
a1201_springHead-master (1)/Rouse_Changes/base_MotorMount.SLDPRT
a1201_springHead-master (1)/Rouse_Changes/front_MotorMount.SLDPRT
a1201_springHead-master (1)/Rouse_Changes/holding fixture base 2.SLDPRT
a1201_springHead-master (1)/Rouse_Changes/holding fixture base 3.SLDPRT
a1201_springHead-master (1)/Rouse_Changes/holding fixture base1.SLDPRT
a1201_springHead-master (1)/Rouse_Changes/p1203_springStop.SLDPRT
a1201_springHead-master (1)/Rouse_Changes/p1204_gearStopSpring.SLDPRT
a1201_springHead-master (1)/Rouse_Changes/transmission mount 2.SLDPRT
a1201_springHead-master (1)/Rouse_Changes/transmission mount base.SLDPRT
a1201_springHead-master (1)/Rouse_Changes/z_ultraThinBallBearing_mcmaster_6656K110.SLDPRT
a1201_springHead-master (1)/Test Fixture parts/57155K349_STAINLESS STEEL BALL BEARING.SLDPRT
a1201_springHead-master (1)/Test Fixture parts/57155K349_STAINLESS STEEL BALL BEARING.x_t
a1201_springHead-master (1)/Test Fixture parts/HoldingFixture.x_t
a1201_springHead-master (1)/Test Fixture parts/HoldingFixtureRight.x_t
a1201_springHead-master (1)/Test Fixture parts/bearing fixture.x_t
a1201_springHead-master (1)/Test Fixture parts/p1201_springV2.x_t
a1201_springHead-master (1)/Test Fixture parts/p1203_springStop.x_t
a1201_springHead-master (1)/Test Fixture parts/p1204_gearStopSpring.x_t
a1201_springHead-master (1)/Test Fixture parts/p1205_springGear_sdpsi_A_1C29MY05024_newpart.x_t
a1201_springHead-master (1)/Test Fixture parts/z_dowelPin_3mm_5mm_mcmaster_91595A143.SLDPRT
a1201_springHead-master (1)/Test Fixture parts/z_dowelPin_3mm_5mm_mcmaster_91595A143.x_t
a1201_springHead-master (1)/Test Fixture parts/z_ultraThinBallBearing_mcmaster_6656K110.SLDPRT
a1201_springHead-master (1)/Test Fixture parts/z_ultraThinBallBearing_mcmaster_6656K110.x_t
a1201_springHead-master (1)/p1012_stage3OutputPulley_5mm_48teeth_newpart.SLDPRT
a1201_springHead-master (1)/p1205_springGear_sdpsi_A_1C29MY05024_newpart.SLDPRT
a1201_springHead-master (1)/parts for quotes/HoldingFixture.SLDDRW
a1201_springHead-master (1)/parts for quotes/HoldingFixtureRight.SLDDRW
a1201_springHead-master (1)/parts for quotes/Key.SLDDRW
a1201_springHead-master (1)/parts for quotes/MotorShaft.SLDDRW
a1201_springHead-master (1)/parts for quotes/p1012_stage3OutputPulley_5mm_48teeth_newpart.SLDDRW
a1201_springHead-master (1)/parts for quotes/p1205_springGear_sdpsi_A_1C29MY05024_newpart.SLDDRW
a1201_springHead-master (1)/parts for quotes/transmission coupler.SLDDRW
a1201_springHead-master (1)/transmission coupler.SLDPRT
a1201_springHead-master (1)/z_dowelPin_3mm_5mm_mcmaster_91595A143.SLDPRT
a1201_springHead-master (1)/z_ultraThinBallBearing_mcmaster_6656K110.SLDPRT
