neurobionics/a1201_springHead-master-1--20181022T163141Z-001/a1201_springHead-master (1)/HoldingFixture.PDF

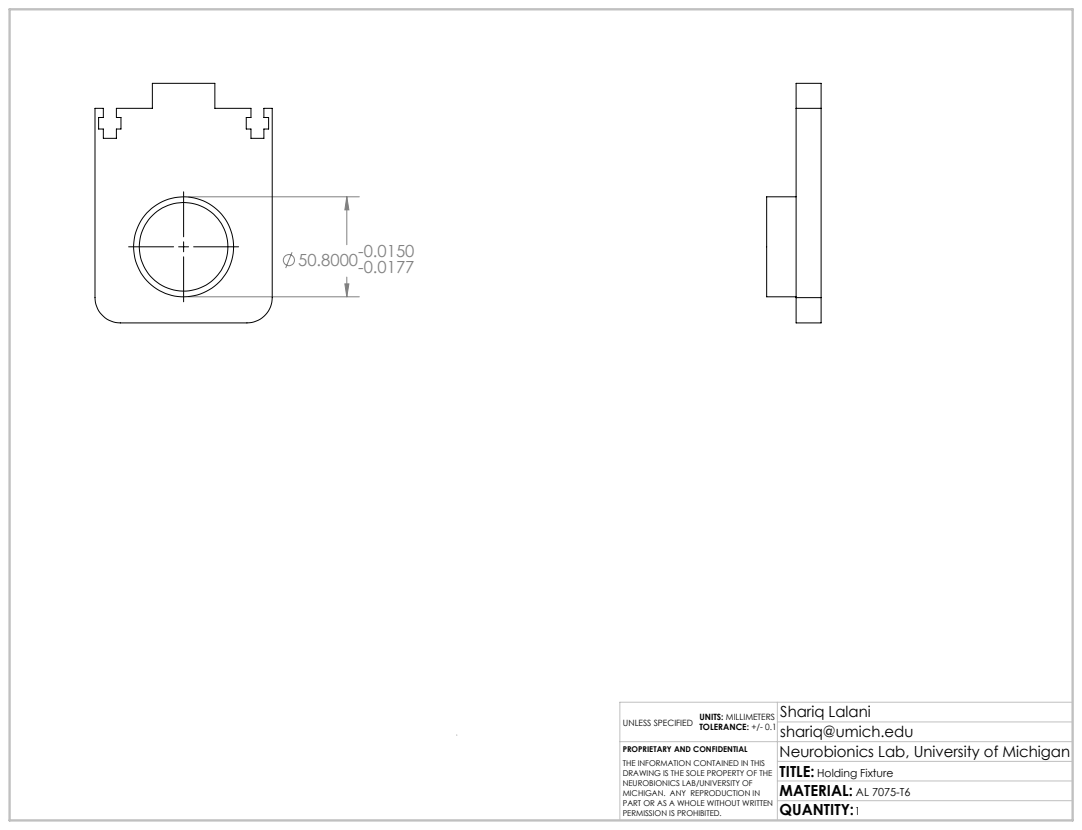
[picture p45: page 1]
UNLESS SPECIFIED; Shariq Lalani

UNITS: MILLIMETERS
TOLERANCE: +/- 0.1 shariq@umich.edu

PROPRIETARY AND CONFIDENTIAL
THE INFORMATION CONTAINED IN THIS
DRAWING IS THE SOLE PROPERTY OF THE
NEUROBIONICS LAB/UNIVERSITY OF
MICHIGAN. ANY REPRODUCTION IN
PART OR AS A WHOLE WITHOUT WRITTEN
PERMISSION IS PROHIBITED.

Neurobionics Lab, University of Michigan
TITLE: Holding Fixture
MATERIAL: AL 7075-T6
QUANTITY:1
