neurobionics/a1201_springHead-master-1--20181022T163141Z-001/(commit log)

2018-10-22 test fixture changes
    [AB0902-1.sldprt, AB0902.sldprt, Key.SLDPRT, P4120403.sldprt, PK920001.sldprt, PL2090-Double-P0403200503.SLDASM, test fixture.SLDASM, transmission coupler.SLDPRT]
2018-10-24 added motor mount to assembly
    [AssemDephy1.SLDASM, MotorShaft.SLDPRT]
2018-10-24 assembly update
    [AssemDephy1.SLDASM, HoldingFixture.SLDPRT, HoldingFixtureRight.SLDPRT]
2018-10-24 assembly updates
    [AssemDephy1.SLDASM, base_MotorMount.SLDPRT, front_MotorMount.SLDPRT]
2018-10-25 updating assembly
    [AB0902.sldprt, PL2090-Double-P0403200503.SLDASM, base_MotorMount.SLDPRT, front_MotorMount.SLDPRT]
2018-10-26 assembly and part updates
    [AssemDephy1.SLDASM, HoldingFixture.SLDPRT, HoldingFixtureRight.SLDPRT, a1201_springHead_newpart.SLDASM, base_MotorMount.SLDPRT, front_MotorMount.SLDPRT, holding fixture base 2.SLDPRT, holding fixture base 3.SLDPRT]
2018-10-26 assembly/part updates
    [a1201_springHead_newpart.SLDASM, p1012_stage3OutputPulley_5mm_48teeth_newpart.SLDPRT, p1205_springGear_sdpsi_A_1C29MY05024_newpart.SLDPRT, transmission coupler.SLDPRT]
2018-11-05 assembly and drawing updates
    [AssemDephy1.SLDASM, Key.SLDDRW, Key.SLDPRT, MotorShaft.SLDDRW, MotorShaft.SLDPRT, a1201_springHead_newpart.SLDASM, p1012_stage3OutputPulley_5mm_48teeth_newpart.SLDDRW, p1012_stage3OutputPulley_5mm_48teeth_newpart.SLDPRT]
2018-11-12 updates
    tolerancing and fixture updates
    [91595A142_METRIC ALLOY STEEL DOWEL PIN.SLDPRT, AssemDephy1.SLDASM, HoldingFixture.SLDDRW, HoldingFixture.SLDPRT, HoldingFixtureRight.SLDDRW, PL2090-Double-P0403200503.SLDASM, a1201_springHead_newpart.SLDASM, base_MotorMount.SLDPRT]
2018-11-16 drawings to pdfs
    [HoldingFixture.SLDDRW, HoldingFixtureRight.SLDDRW, transmission coupler.SLDDRW]
2018-11-18 updates to text fixture
    [AB0902.sldprt, AssemDephy1.SLDASM, HoldingFixture.SLDPRT, HoldingFixtureRight.SLDPRT, PL2090-Double-P0403200503.SLDASM, a1201_springHead_newpart.SLDASM, base_MotorMount.SLDPRT, front_MotorMount.SLDPRT]
2018-12-17 drawing updates
    [HoldingFixture.SLDDRW, HoldingFixtureRight.SLDDRW, Key.SLDDRW, MotorShaft.SLDDRW, p1012_stage3OutputPulley_5mm_48teeth_newpart.SLDDRW, p1205_springGear_sdpsi_A_1C29MY05024_newpart.SLDDRW, transmission coupler.SLDDRW]
2019-01-11 added breadboard
    [MB6090_M-Solidworks.SLDPRT]
